PrashanRaii/self-balancing-bot/Project_Resources/Images/bot with big wheel.jpeg

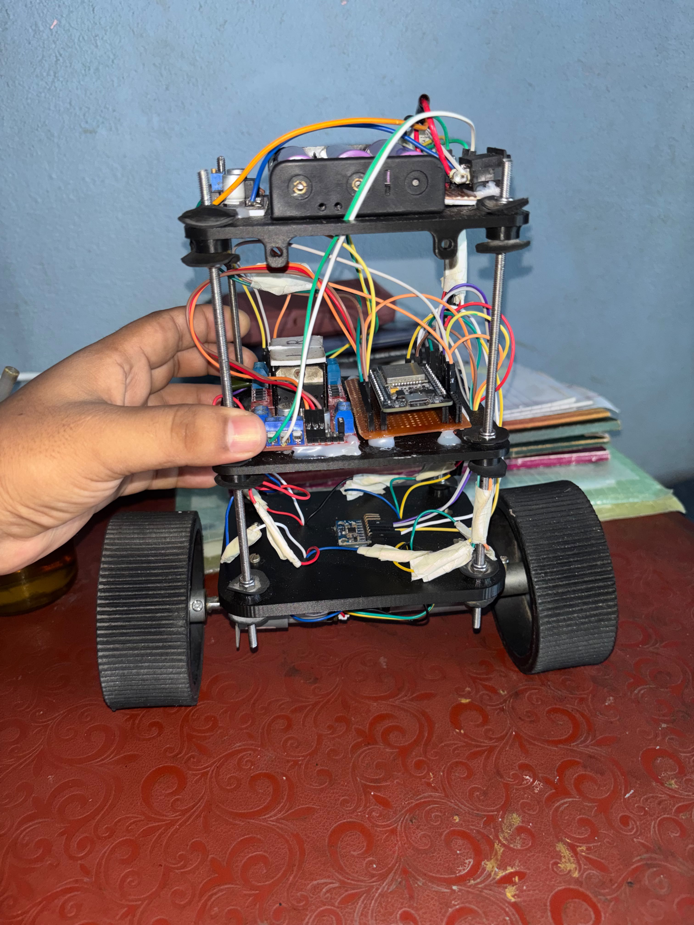
Project_Resources/Images/bot with big wheel.jpeg
