PrashanRaii/self-balancing-bot/Project_Resources/Images/bot small wheel.jpeg

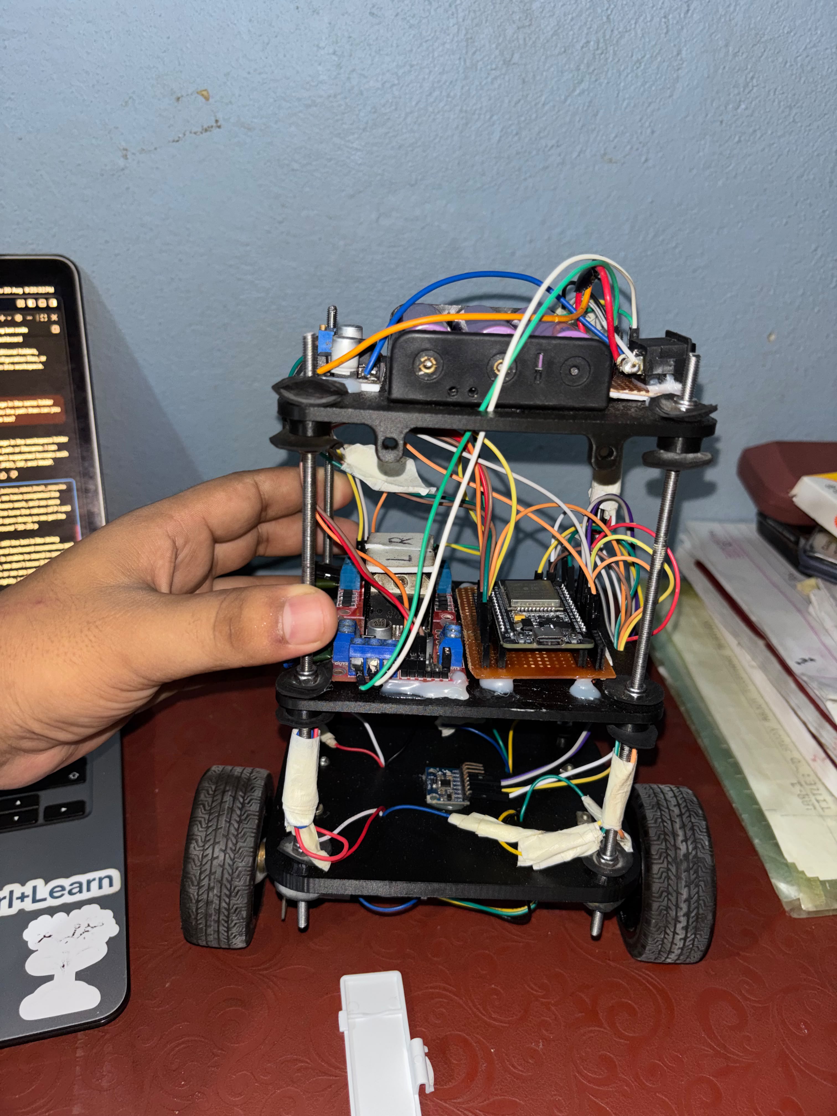
Project_Resources/Images/bot small wheel.jpeg
