PrashanRaii/self-balancing-bot/Project_Resources/Images/Screenshot 2026-08-23 at 9.30.42 PM.png

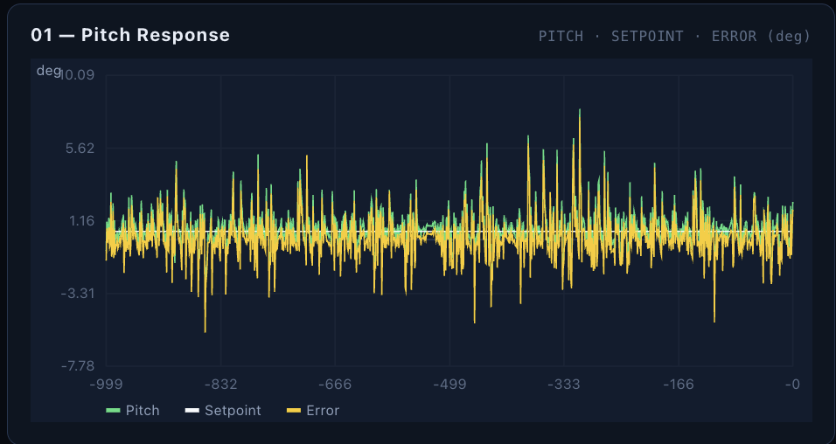
Project_Resources/Images/Screenshot 2026-08-23 at 9.30.42 PM.png
