PrashanRaii/self-balancing-bot/(commit log)

2026-10-07 Initial Project Upload
    [11.csv, 12 0.08 4.csv, 4.6.csv, 5.2 0 1.csv, 6 0 1 -0.4.csv, 6 0.01 1.5 -0.4.csv, 8.05.csv, balance-robot-telemetry-2026-08-22T10-31-15-093Z.csv]
2026-10-09 Final Commit
    [csv.csv]
